Indian-Students-Rocketry-Assocation/Electronics/Missions/M003-HomiSII/Test/2026-09-26_Stair-Test/flight.csv

ms | state | p_Pa | temp_C | h_baro_m | h_m | v_ms | a_vert_ms2 | acc_bias | ax | ay | az | gx | gy | gz | tilt_deg | sat
857 | SAFE | 0 | 27.0 | 0.00 | -0.00 | -0.00 | -0.29 | 0.000 | -9.25 | -0.17 | -2.21 | 0.044 | 0.069 | -0.153 | 103.4 | 0
957 | SAFE | 100321 | 27.0 | 1.17 | 0.71 | -0.02 | -0.17 | -0.014 | -9.33 | 0.03 | -2.41 | -0.040 | 0.034 | 0.100 | 104.5 | 0
1057 | SAFE | 100321 | 27.0 | 1.17 | 0.93 | -0.02 | -0.32 | -0.076 | -9.17 | -0.18 | -2.42 | 0.087 | 0.296 | 0.077 | 104.8 | 0
1157 | SAFE | 100315 | 27.0 | 1.67 | 1.14 | 0.08 | -0.20 | -0.315 | -9.58 | -0.35 | -0.56 | 0.780 | -0.679 | 0.646 | 93.3 | 0
1257 | SAFE | 100314 | 27.0 | 1.76 | 1.27 | 0.21 | -2.29 | -0.641 | -7.41 | 0.66 | -1.54 | 0.707 | 0.150 | 0.139 | 110.0 | 0
1357 | SAFE | 100313 | 27.0 | 1.84 | 1.52 | 0.69 | 0.24 | -1.434 | -9.50 | -0.11 | -3.25 | 3.154 | -0.403 | 0.016 | 108.9 | 0
1457 | SAFE | 100315 | 27.0 | 1.67 | 1.60 | 0.84 | -0.38 | -1.476 | -9.20 | 0.42 | -2.04 | 0.268 | -0.014 | -0.321 | 102.5 | 0
1557 | SAFE | 100311 | 27.0 | 2.01 | 1.70 | 0.99 | -0.13 | -1.504 | -9.35 | -0.28 | -2.47 | 0.066 | -0.029 | -0.037 | 104.8 | 0
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
