Indian-Students-Rocketry-Assocation/Electronics/Missions/M003-HomiSII/Test/2026-09-26_Stair-Test/flight.png

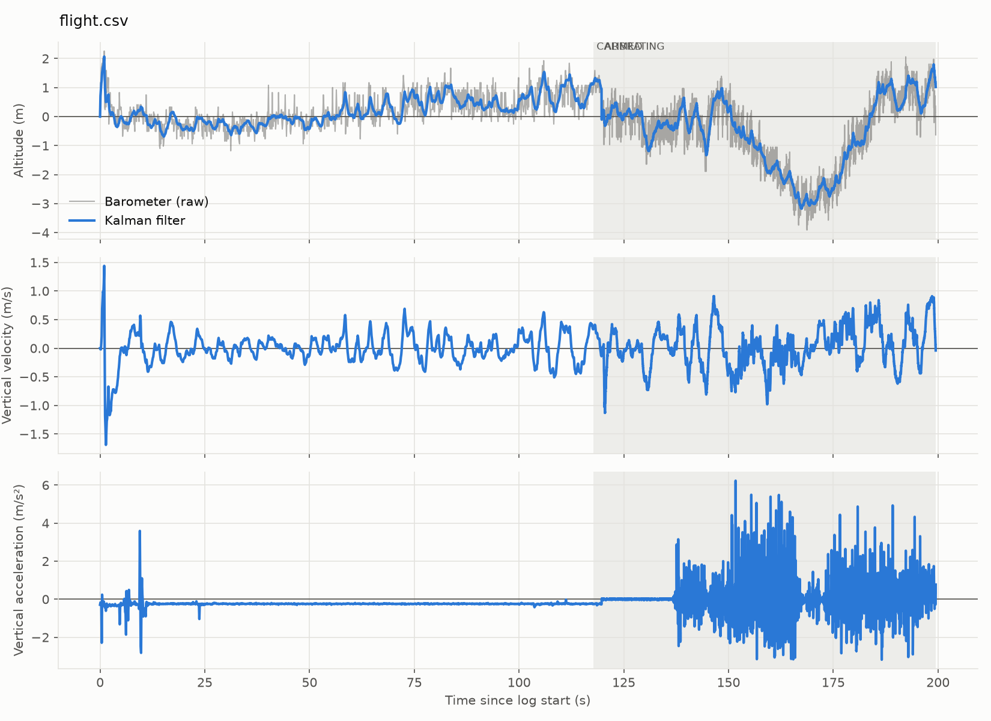
Missions/M003-HomiSII/Test/2026-09-26_Stair-Test/flight.png
