Indian-Students-Rocketry-Assocation/Electronics/(commit log)

2026-09-27 new avionics code
    [flight.csv]
2026-09-27 [M003] Organise mission folder and docs
    - Move the 2026-09-26 indoor stair test into Test/2026-09-26_Stair-Test/
    (fix flight.png.png name) and record its results in the mission README
    - Fold wiring, pin map, IDE settings and problems-solved into
    FlightComputer/README.md; remove esp32cam_gy87_project_1.md
    - Remove the superseded Logger sketch and the internal HANDOFF.md
    - Point the firmware header comment at the README
    [flight.csv]
2026-09-27 [M003] Add flight computer circuit diagram
2026-09-27 [M003] Document 2S LiPo + buck power, 1000 uF on buck output, direct serial wiring
2026-09-27 [M003] Circuit: single buck output, 1000 uF across it, branches to servo and ESP32-CAM
2026-09-27 [M001][M002] Add retrospective electronics records
    Both boards were destroyed at launch and no code or data survives;
    parts lists and outcomes written from the team's memory.
